fraciscoestar/BLDC_driver_small/BLDC_driver_small.kicad_pcb

## KiCad design BLDC_driver_small.kicad_pcb (2023-03-20)

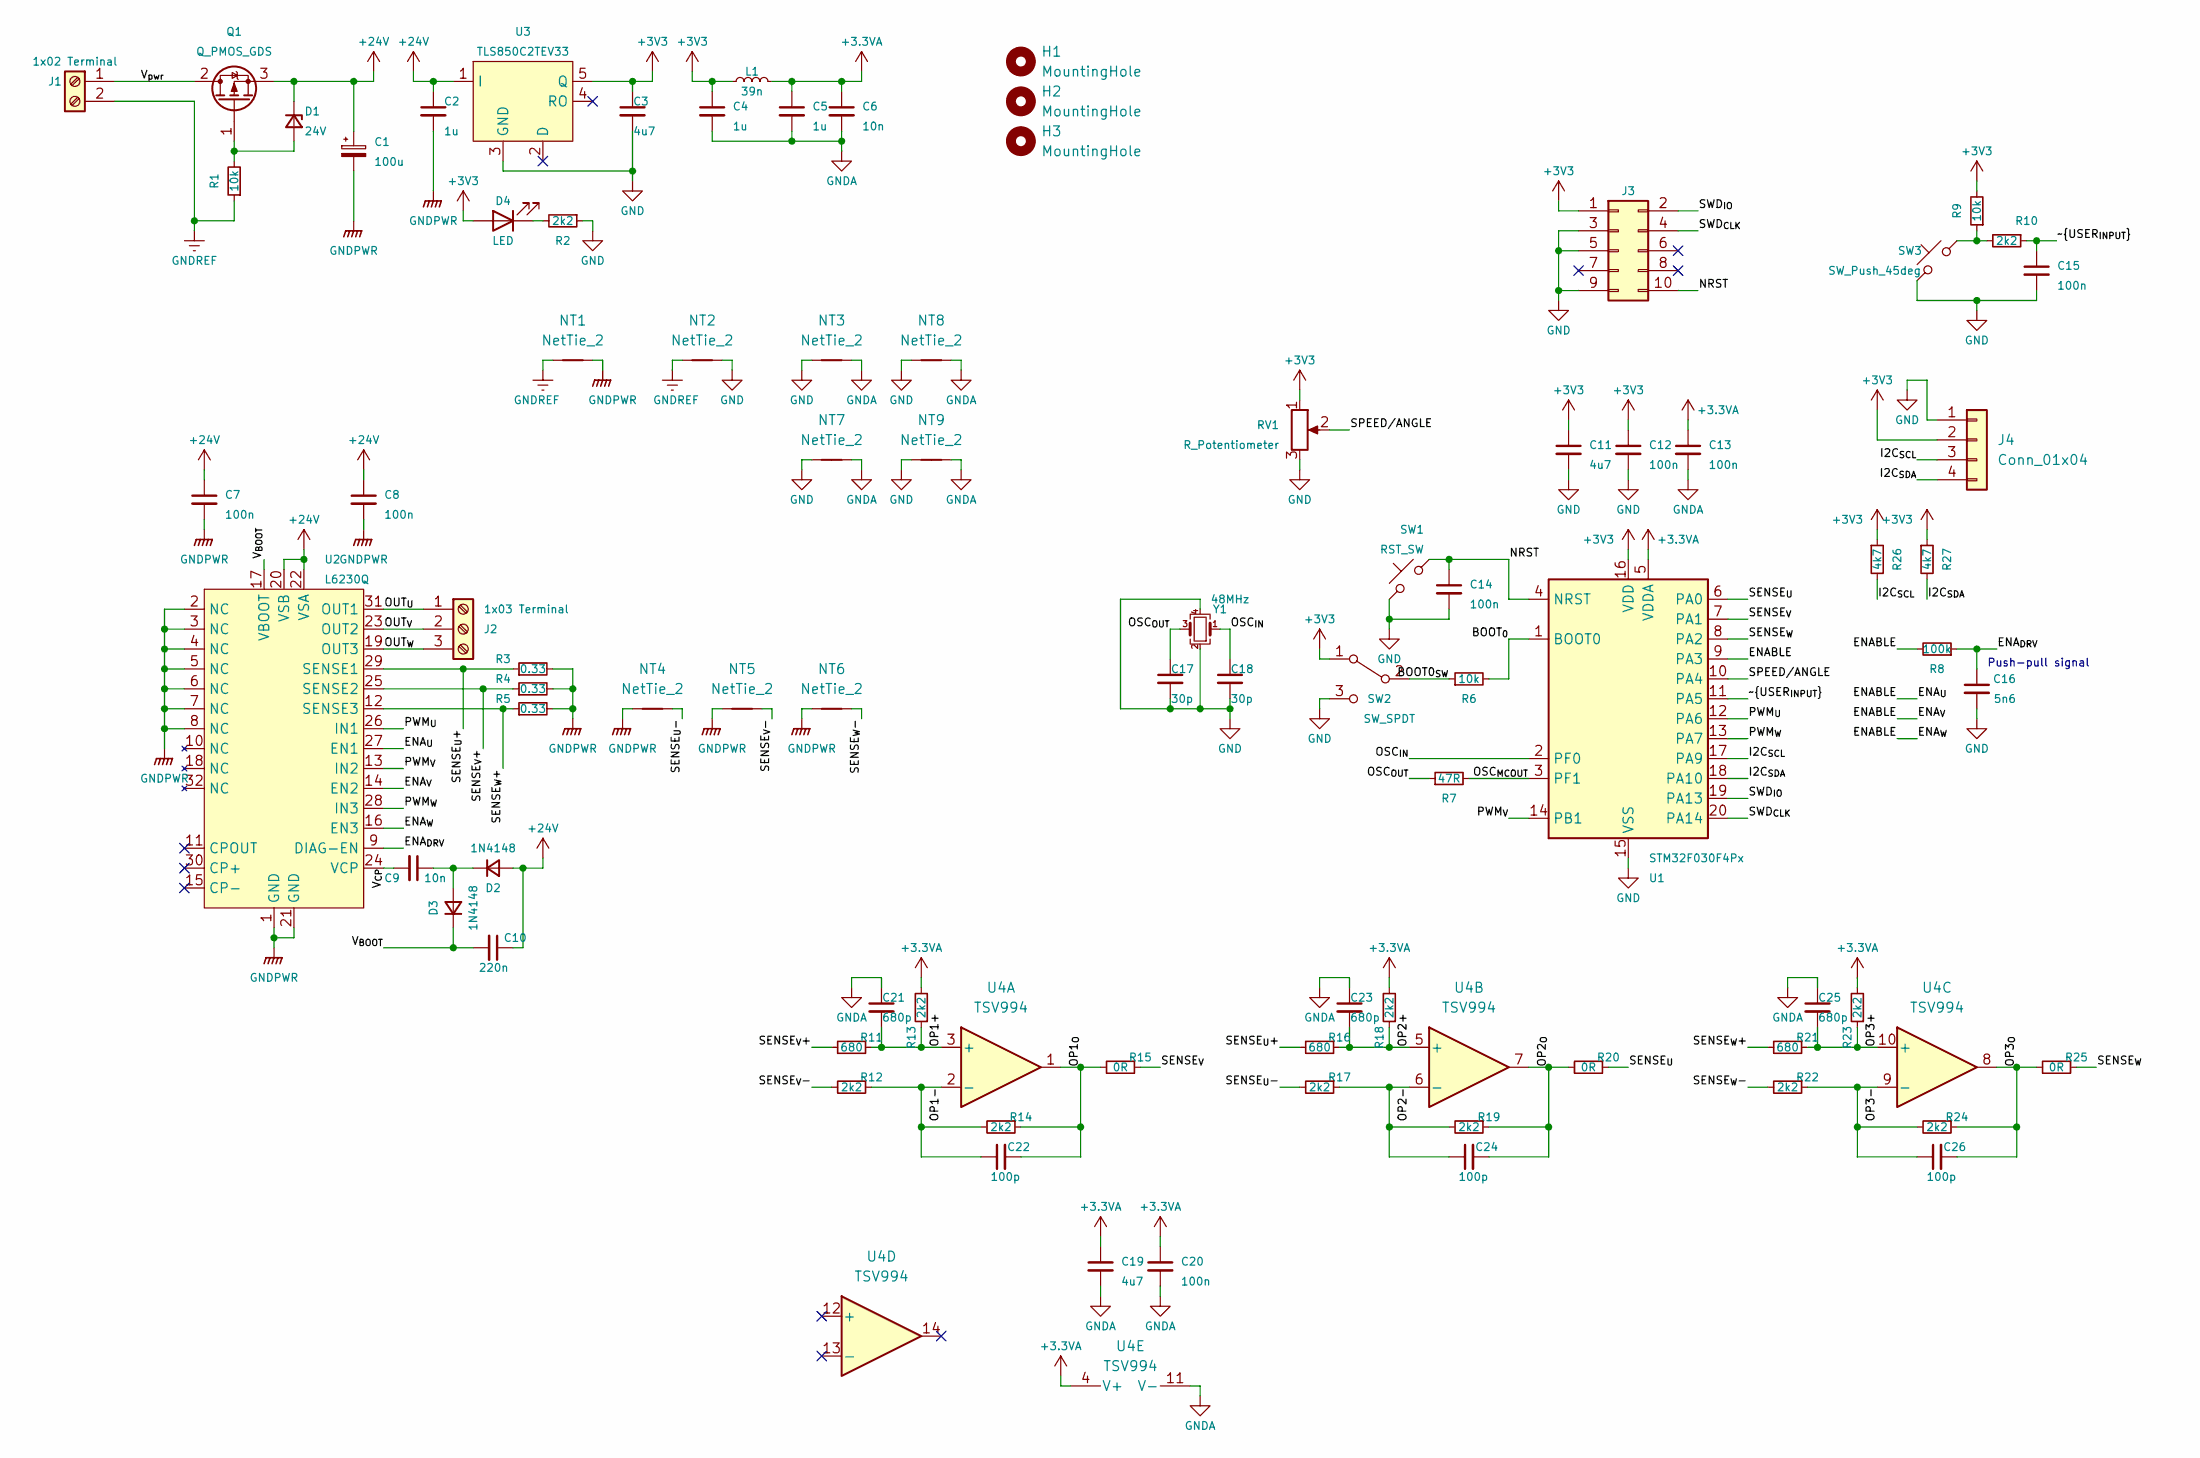
[picture p1: schematic BLDC_driver_small.kicad_sch]

Parts:
C1: 100u; CP_Elec_10x10.5; MPN 865060757007
C2: 1u; C_0603_1608Metric; MPN UMK107BJ105KA-T
C3: 4u7; C_0603_1608Metric; MPN GRM188R6YA475KE15J
C4, C5: 1u; C_0402_1005Metric; MPN EMK105BJ105KV8F
C6, C9: 10n; C_0402_1005Metric; MPN UMK105B7103KV-F
C7, C8, C12, C13, C14, C15, C20: 100n; C_0402_1005Metric; MPN 885012205092
C10: 220n; C_0402_1005Metric; MPN TMK105B7224KV-FR
C11, C19: 4u7; C_0402_1005Metric; MPN GRM155C61E475ME15J
C16: 5n6; C_0402_1005Metric; MPN GRM155R71E562JA01D
C17, C18: 30p; C_0402_1005Metric; MPN 04025A300FAT2A
C21, C23, C25: 680p; C_0402_1005Metric; MPN MAASH105SB7681KFCA01
C22, C24, C26: 100p; C_0402_1005Metric; MPN C0402C101K3RACAUTO
D1: 24V; D_SOD-123; MPN MMSZ5252C-G3-08
D2, D3: 1N4148; D_SOD-523; MPN 1N4148X-TP
D4: LED; LED_0603_1608Metric; MPN 150060GS75000
H1, H2, H3: MountingHole; MountingHole_2.2mm_M2
J1: 1x02 Terminal; TerminalBlock_Altech_AK300-2_P5.00mm; MPN 1711026
J2: 1x03 Terminal; TerminalBlock_Altech_AK300-3_P5.00mm; MPN 1711039
J3: Conn_02x05_Odd_Even; PinHeader_2x05_P2.54mm_Vertical; MPN 5103310-1
J4: Conn_01x04; PinHeader_1x04_P2.54mm_Vertical; MPN 90147-1204
L1: 39n; L_0603_1608Metric; MPN LQG18HN39NJ00D
NT1, NT2: NetTie_2; NetTie-2_SMD_Pad2.0mm
NT3, NT4, NT5, NT6, NT7, NT8, NT9: NetTie_2; NetTie-2_SMD_Pad0.5mm
Q1: Q_PMOS_GDS; SOT-23; MPN SQ2319ADS-T1_BE3
R1, R6, R9: 10k; R_0402_1005Metric; MPN ERJ-2RKF1002X
R2, R10, R12, R13, R14, R17, R18, R19, R22, R23, R24: 2k2; R_0402_1005Metric; MPN ERJ-2RKF2201X
R3, R4, R5: 0.33; R_1210_3225Metric; MPN RCWE1210R330FKEA
R7: 47R; R_0402_1005Metric; MPN ERJ-2RKF47R0X
R8: 100k; R_0402_1005Metric; MPN ERJ-2RKF1003X
R11, R16, R21: 680; R_0402_1005Metric; MPN ERJ-2RKF6800X
R15, R20, R25: 0R; R_0402_1005Metric; MPN ERJ-2GE0R00X
R26, R27: 4k7; R_0402_1005Metric; MPN ERJ-2RKF4701X
RV1: R_Potentiometer; Potentiometer_Bourns_3314S_Horizontal; MPN 3314J-1-204E
SW1: RST_SW; SW_SPST_B3S-1000; MPN K2-1157SP-B3SW-01
SW2: SW_SPDT; SW_SPDT_PCM12; MPN SK-3296S-01-L1
SW3: SW_Push_45deg; SW_SPST_B3S-1000; MPN K2-1157SP-B3SW-01
U1: STM32F030F4Px; TSSOP-20_4.4x6.5mm_P0.65mm; MPN STM32F030F4P6
U2: L6230Q; VFQFPN32; MPN L6230Q
U3: TLS850C2TEV33; PG-TO252-5; MPN TLS850C2TEV33
U4: TSV994; TSSOP-14_4.4x5mm_P0.65mm; MPN TSV994
Y1: 48MHz; Crystal_SMD_3225-4Pin_3.2x2.5mm; MPN 7B048000R01

Connections:
+3.3VA: C5.1, C6.1, C13.1, C19.1, C20.1, L1.2, R13.2, R18.2, R23.2, U1.5 (VDDA), U4.4 (V+)
+3V3: C3.1, C4.1, C11.1, C12.1, D4.2 (A), J3.1, J4.2, L1.1, R9.2, R26.1, R27.1, RV1.1, SW2.1 (A), U1.16 (VDD), U3.5 (Q)
+24V: C1.1, C2.1, C7.1, C8.1, C10.1, D1.1 (K), D2.2 (A), Q1.3 (S), U2.20 (VSB), U2.22 (VSA), U3.1 (I)
/BOOT0_{SW}: R6.1, SW2.2 (B)
/BOOT_{0}: R6.2, U1.1 (BOOT0)
/ENABLE: R8.2, U1.9 (PA3), U2.14 (EN2), U2.16 (EN3), U2.27 (EN1)
/ENA_{DRV}: C16.1, R8.1, U2.9 (DIAG-EN)
/I2C_{SCL}: J4.3, R26.2, U1.17 (PA9)
/I2C_{SDA}: J4.4, R27.2, U1.18 (PA10)
/NRST: C14.1, J3.10, SW1.2, U1.4 (NRST)
/OP1+: C21.2, R11.1, R13.1, U4.3 (+)
/OP1-: C22.1, R12.1, R14.2, U4.2 (-)
/OP1_{O}: C22.2, R14.1, R15.2, U4.1
/OP2+: C23.2, R16.1, R18.1, U4.5 (+)
/OP2-: C24.1, R17.1, R19.2, U4.6 (-)
/OP2_{O}: C24.2, R19.1, R20.2, U4.7
/OP3+: C25.2, R21.1, R23.1, U4.10 (+)
/OP3-: C26.1, R22.1, R24.2, U4.9 (-)
/OP3_{O}: C26.2, R24.1, R25.2, U4.8
/OSC_{IN}: C18.1, U1.2 (PF0), Y1.1
/OSC_{MCOUT}: R7.2, U1.3 (PF1)
/OSC_{OUT}: C17.1, R7.1, Y1.3
/OUT_{U}: J2.1, U2.31 (OUT1)
/OUT_{V}: J2.2, U2.23 (OUT2)
/OUT_{W}: J2.3, U2.19 (OUT3)
/PWM_{U}: U1.12 (PA6), U2.26 (IN1)
/PWM_{V}: U1.14 (PB1), U2.13 (IN2)
/PWM_{W}: U1.13 (PA7), U2.28 (IN3)
/SENSE_{U}: R20.1, U1.6 (PA0)
/SENSE_{U}+: R3.1, R16.2, U2.29 (SENSE1)
/SENSE_{U}-: NT4.2, R17.2
/SENSE_{V}: R15.1, U1.7 (PA1)
/SENSE_{V}+: R4.1, R11.2, U2.25 (SENSE2)
/SENSE_{V}-: NT5.2, R12.2
/SENSE_{W}: R25.1, U1.8 (PA2)
/SENSE_{W}+: R5.1, R21.2, U2.12 (SENSE3)
/SENSE_{W}-: NT6.2, R22.2
/SPEED/ANGLE: RV1.2, U1.10 (PA4)
/SWD_{CLK}: J3.4, U1.20 (PA14)
/SWD_{IO}: J3.2, U1.19 (PA13)
/V_{BOOT}: C10.2, D3.1 (K), U2.17 (VBOOT)
/V_{CP}: C9.2, U2.24 (VCP)
/V_{pwr}: J1.1, Q1.2 (D)
/~USER_{INPUT}: C15.1, R10.1, U1.11 (PA5)
GND: C3.2, C11.2, C12.2, C14.2, C15.2, C16.2, C17.2, C18.2, J3.3, J3.5, J3.9, J4.1, NT2.2, NT3.1, NT7.1, NT8.1, NT9.1, R2.1, RV1.3, SW1.1, SW2.3 (C), SW3.1, U1.15 (VSS), U3.3 (GND), Y1.2, Y1.4
GNDA: C4.2, C5.2, C6.2, C13.2, C19.2, C20.2, C21.1, C23.1, C25.1, NT3.2, NT7.2, NT8.2, NT9.2, U4.11 (V-)
GNDPWR: C1.2, C2.2, C7.2, C8.2, NT1.2, NT4.1, NT5.1, NT6.1, R3.2, R4.2, R5.2, U2.1 (GND), U2.2 (NC), U2.3 (NC), U2.4 (NC), U2.5 (NC), U2.6 (NC), U2.7 (NC), U2.8 (NC), U2.21 (GND)
GNDREF: J1.2, NT1.1, NT2.1, R1.1
unnamed: C9.1, D2.1 (K), D3.2 (A)
unnamed: D1.2 (A), Q1.1 (G), R1.2
unnamed: D4.1 (K), R2.2
unnamed: R9.1, R10.2, SW3.2

Notes on the sheet:
Push-pull signal

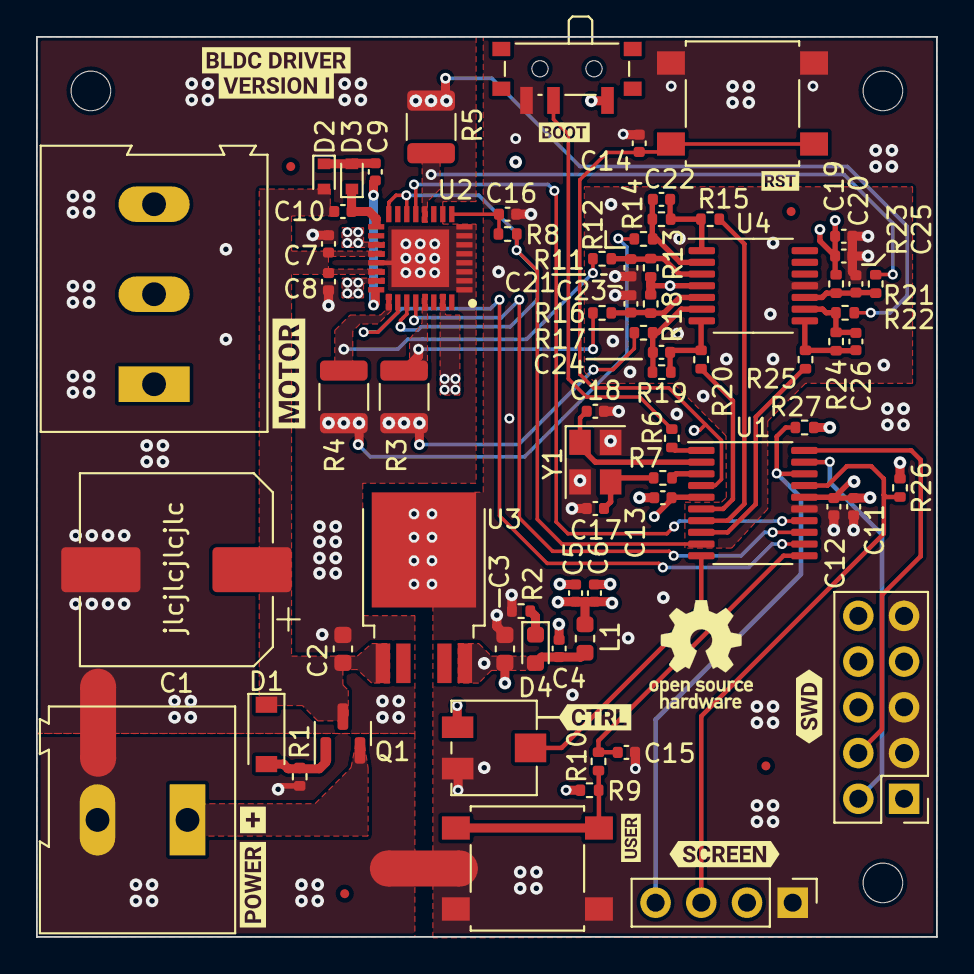
[picture p2: board BLDC_driver_small.kicad_pcb from above]

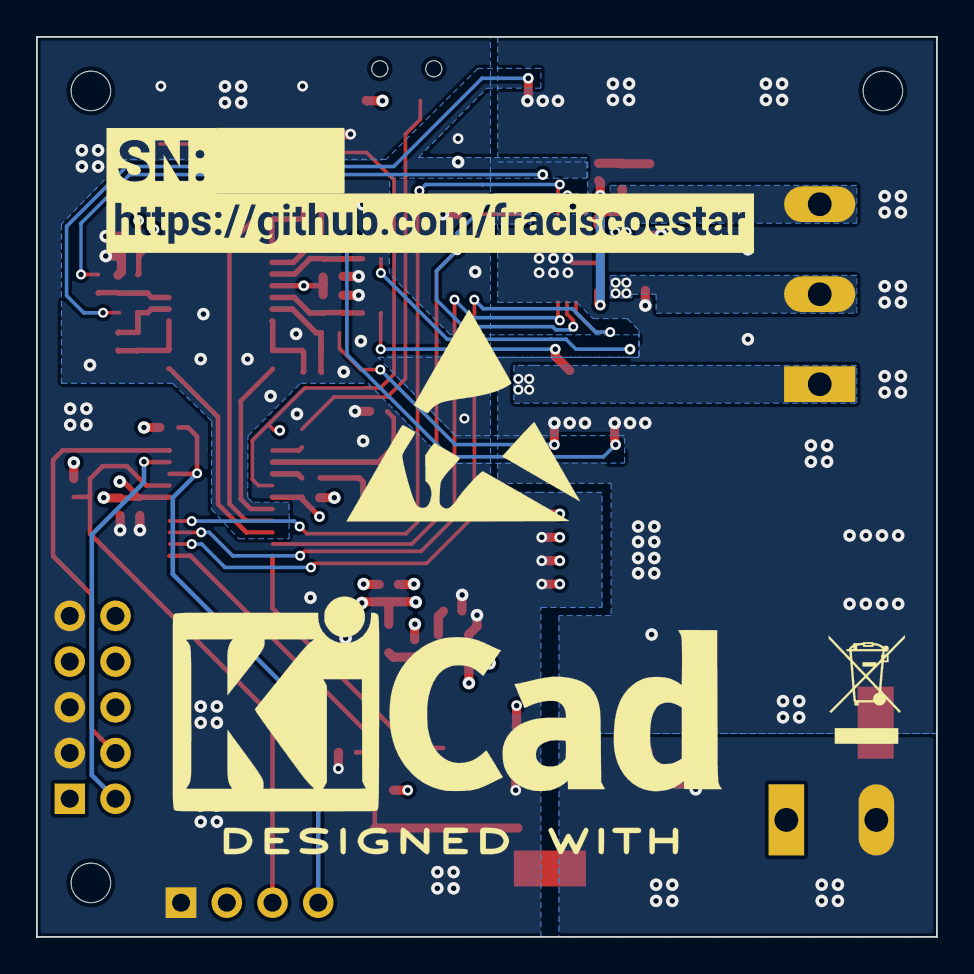
[picture p3: board BLDC_driver_small.kicad_pcb from below]

Board: 6 copper layers, 50.0 x 50.0 mm, 97 parts (2 on the bottom side), 52 nets.

Other parts of the board:
kibuzzard-641818A1: G***; kibuzzard-641818A1
kibuzzard-641842DD: G***; kibuzzard-641842DD
kibuzzard-641842EC: G***; kibuzzard-641842EC
kibuzzard-641877D0: G***; kibuzzard-641877D0
kibuzzard-641879B1: G***; kibuzzard-641879B1
kibuzzard-6418180F: G***; kibuzzard-6418180F
kibuzzard-6418190C: G***; kibuzzard-6418190C
kibuzzard-6418363F: G***; kibuzzard-6418363F
kibuzzard-64181824: G***; kibuzzard-64181824
kibuzzard-64183623: G***; kibuzzard-64183623
kibuzzard-64183651: G***; kibuzzard-64183651
kibuzzard-64183661: G***; kibuzzard-64183661
kibuzzard-64183696: G***; kibuzzard-64183696
